serillius/TrashFlash/README.md

View this project on [CADLAB.io](https://cadlab.io/project/28978). 

# TrashFlash
