serillius/TrashFlash/3D_Model/BatteryConnector.png

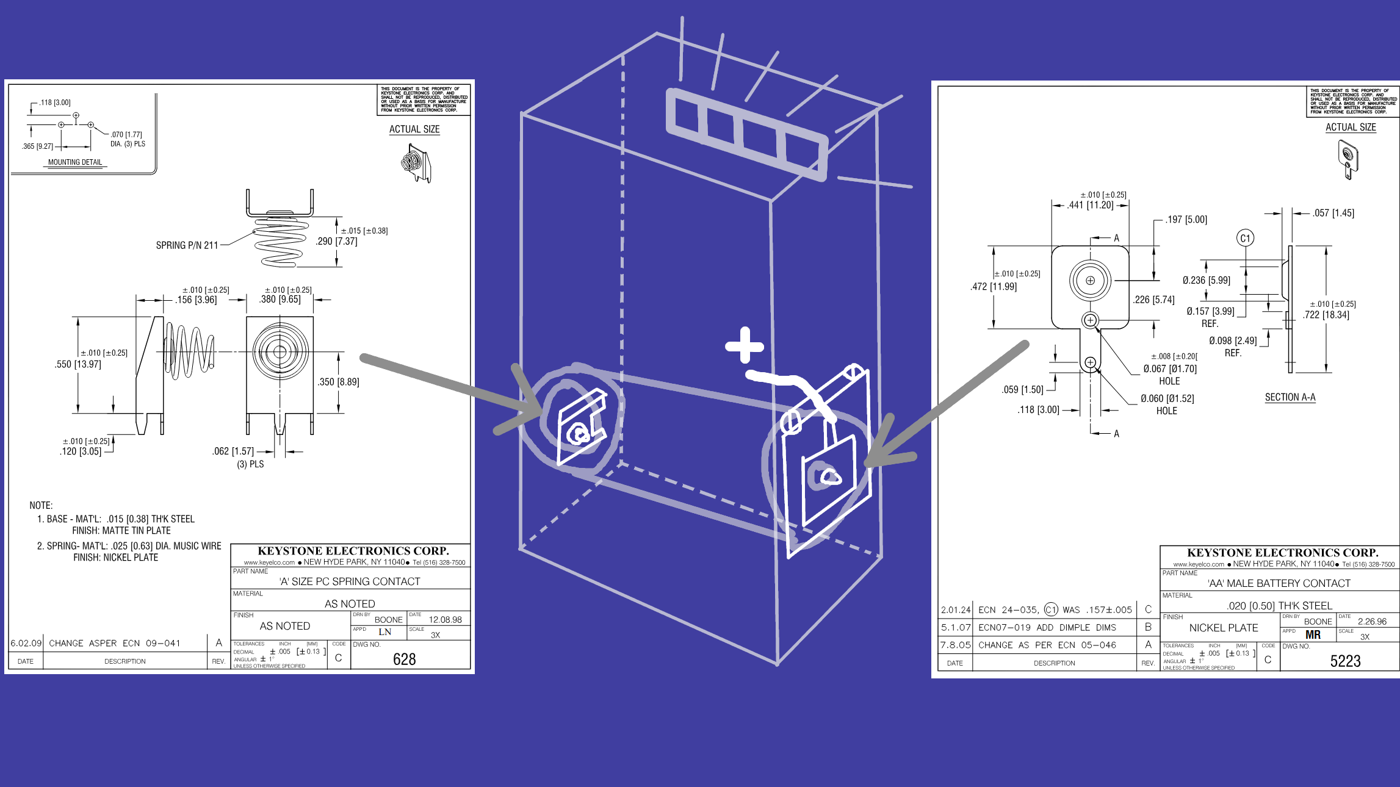
3D_Model/BatteryConnector.png
