serillius/TrashFlash/3D_Model/batteryAssembly.FCStd

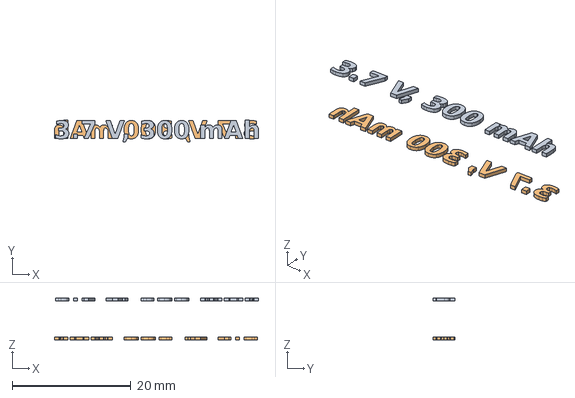
[picture p2: CAD file, 2025-04-07]
3D_Model/batteryAssembly.FCStd
34.4 x 3.71 x 7.00 mm
