serillius/TrashFlash/3D_Model/PCB_Assembly.FCStd

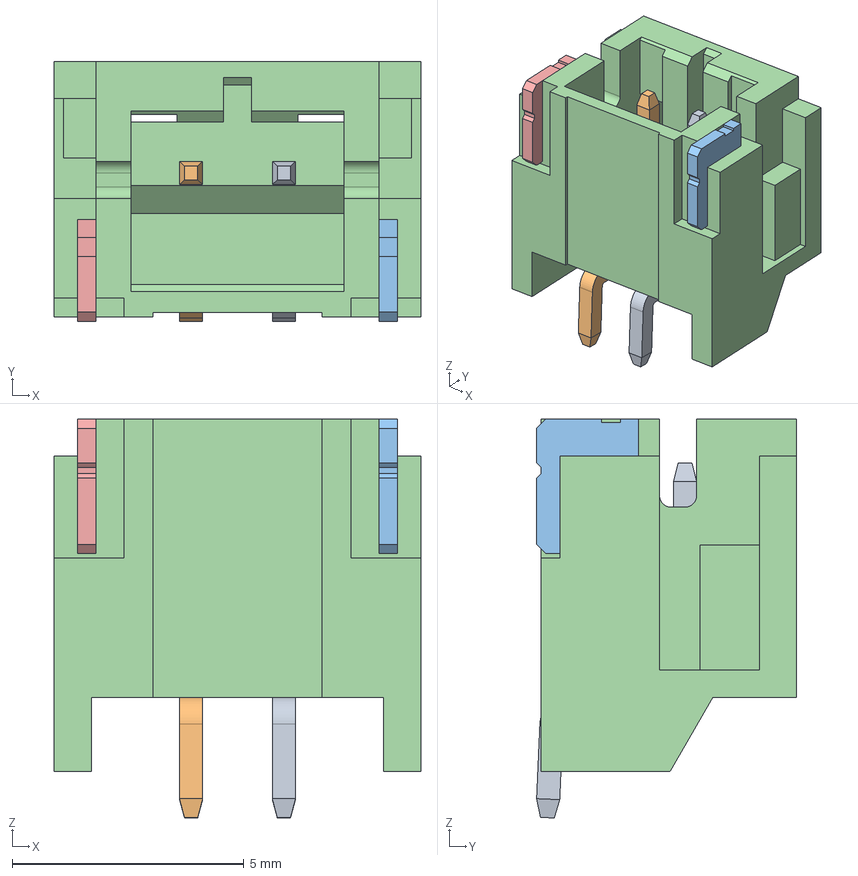
[picture p3: CAD file, 2025-03-31]
3D_Model/PCB_Assembly.FCStd
7.90 x 5.60 x 8.60 mm
S2B-PH-SM4-TB(LF)(SN)
S2B-PH-SM4-TB(LF)(SN)001
S2B-PH-SM4-TB(LF)(SN)002
S2B-PH-SM4-TB(LF)(SN)003
S2B-PH-SM4-TB(LF)(SN)004
