serillius/TrashFlash/3D_Model/CAP_UBY_18X25_NCH.step

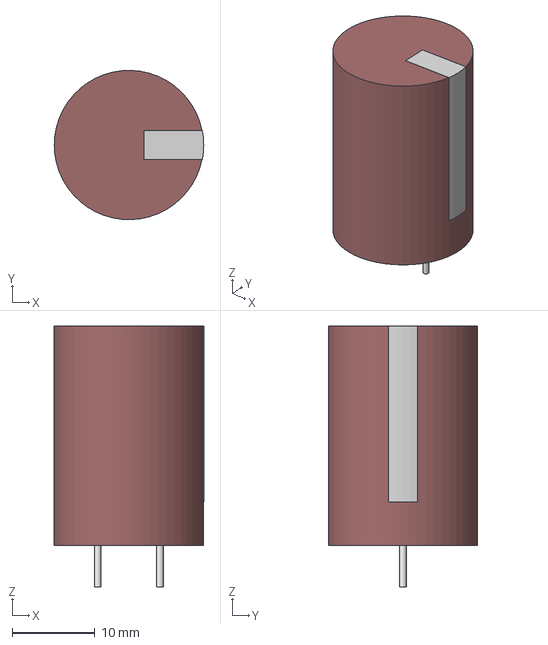
[picture p4: CAD file, 2025-04-09]
3D_Model/CAP_UBY_18X25_NCH.step
18.0 x 18.0 x 31.5 mm
