serillius/TrashFlash/Components/3D/FTSH-107-01-L-DV-K-A.stp

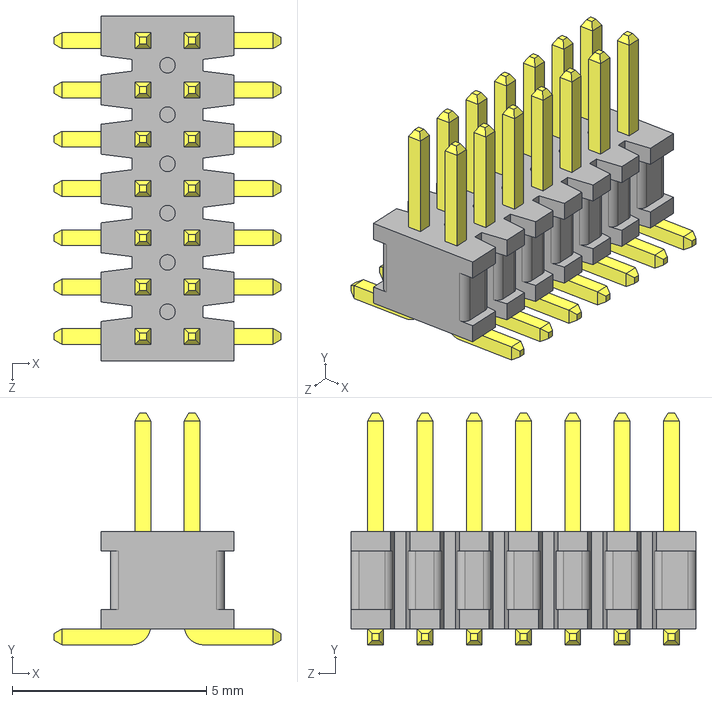
[picture p5: CAD file, 2025-04-23]
Components/3D/FTSH-107-01-L-DV-K-A.stp
5.84 x 5.97 x 8.89 mm
