serillius/TrashFlash/3D_Model/Battery.FCStd

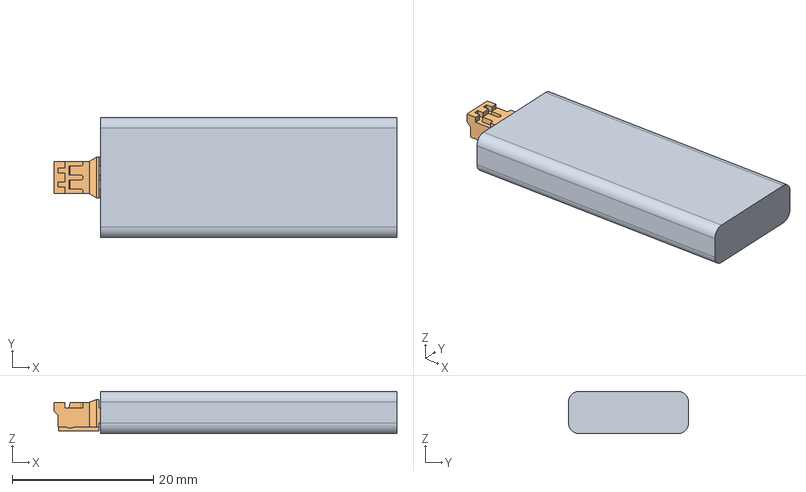
[picture p7: CAD file, 2025-04-07]
3D_Model/Battery.FCStd
48.6 x 17.0 x 6.00 mm
PHR-2
