serillius/TrashFlash/3D_Model/ec11e09244aq.stl

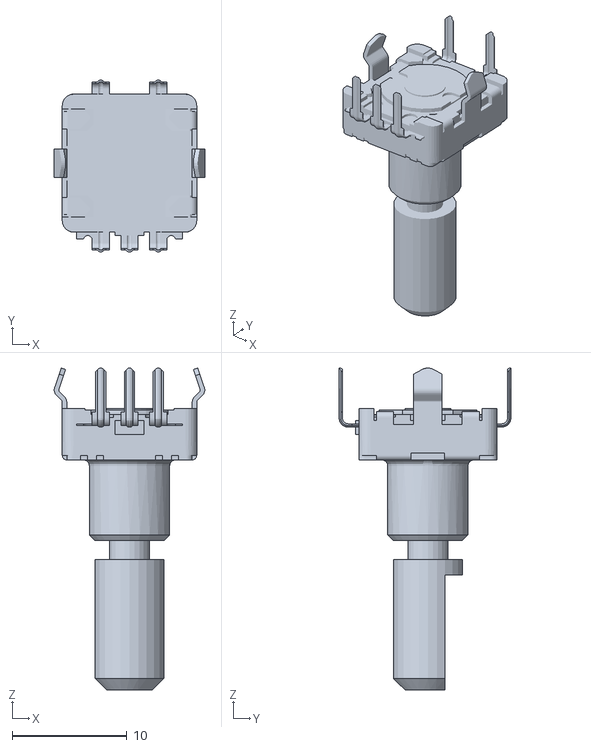
[picture p8: CAD file, 2025-04-06]
3D_Model/ec11e09244aq.stl
13.1 x 14.9 x 28.0
