serillius/TrashFlash/Components/3D/0900AT43A0070E.stp

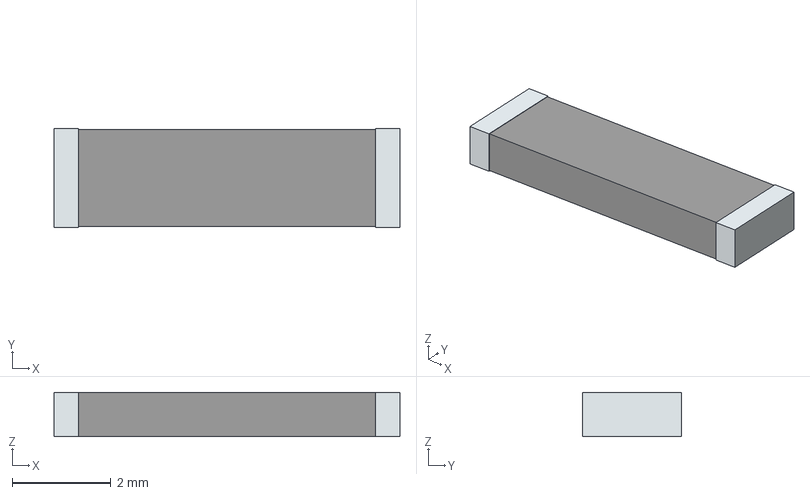
[picture p9: CAD file, 2025-04-23]
Components/3D/0900AT43A0070E.stp
7.00 x 2.00 x 0.9 mm
term1
term2
