serillius/TrashFlash/Components/3D/CC110LRGPR.stp

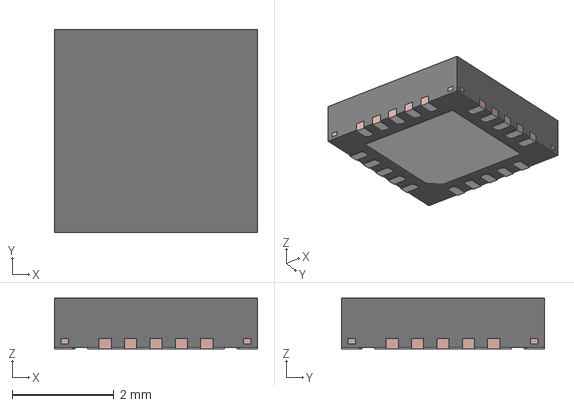
[picture p10: CAD file, 2025-04-23]
Components/3D/CC110LRGPR.stp
4.00 x 4.00 x 1.00 mm
FRAME
