serillius/TrashFlash/3D_Model/Hotshoe.FCStd

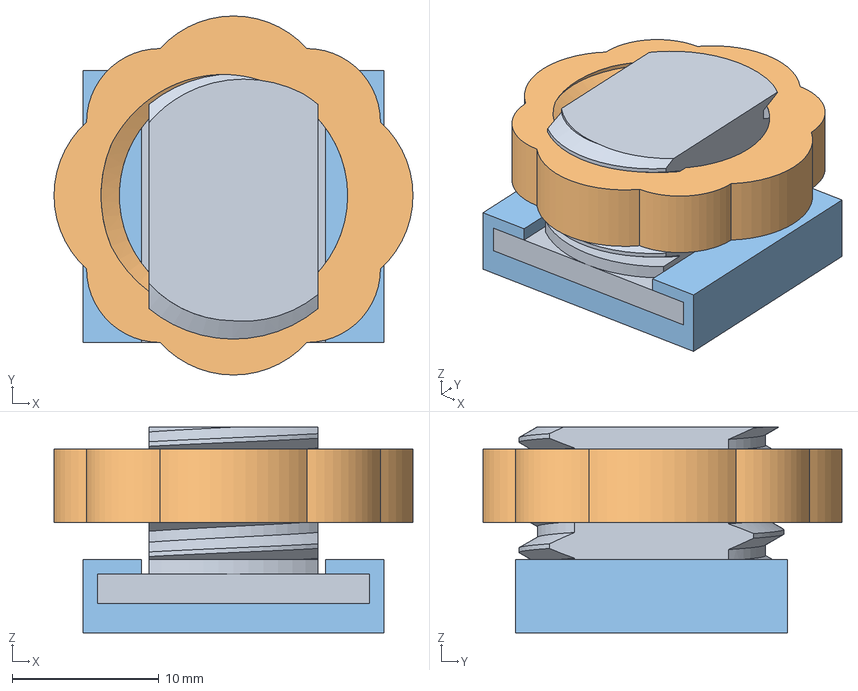
[picture p11: CAD file, 2025-03-31]
3D_Model/Hotshoe.FCStd
24.4 x 24.4 x 14.0 mm
Thread001
Hotshoe
