serillius/TrashFlash/3D_Model/XLamp XHP50.x HD.STEP

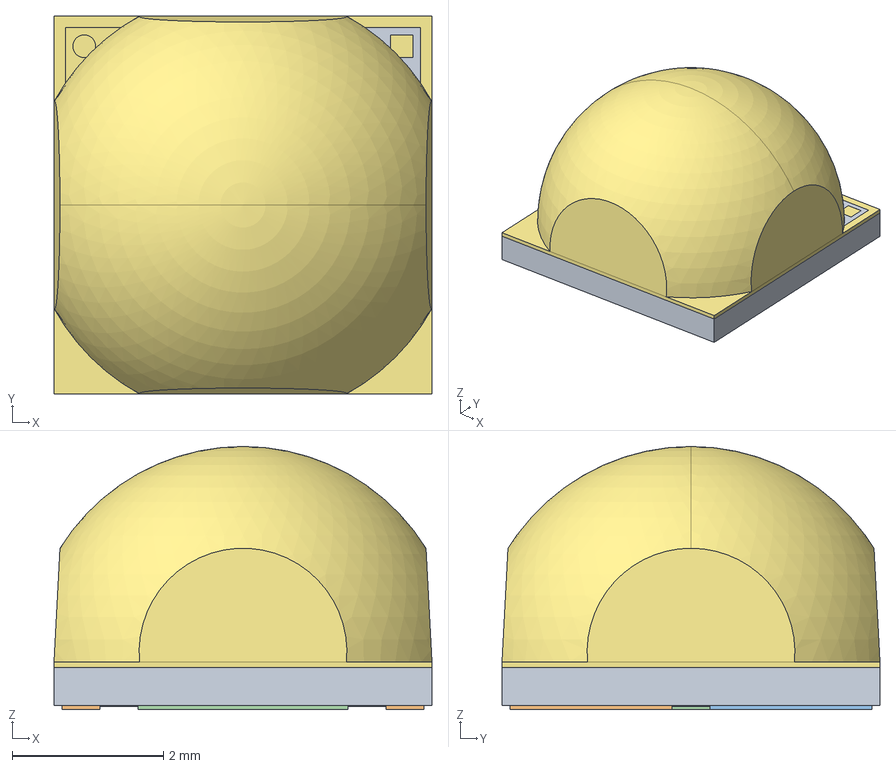
[picture p12: CAD file, 2025-03-31]
3D_Model/XLamp XHP50.x HD.STEP
5.00 x 5.00 x 3.48 mm
2500-00676-C
2500-00676-BT
2500-00676-SMB
2500-00676-SMB1
2500-00676-TT
2500-00676-TS
2610-00073-DOME
