serillius/TrashFlash/Components/3D/SN74LXC2T45QDTTRQ1.stp

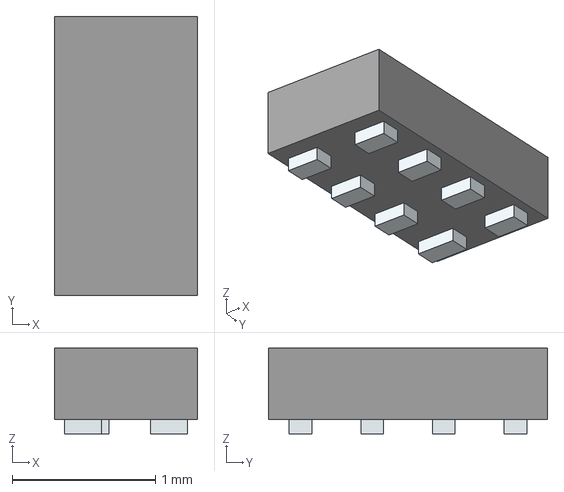
[picture p13: CAD file, 2025-04-07]
Components/3D/SN74LXC2T45QDTTRQ1.stp
1.00 x 1.95 x 0.6 mm
Pins
