serillius/TrashFlash/Components/3D/BC56-10PA,115.stp

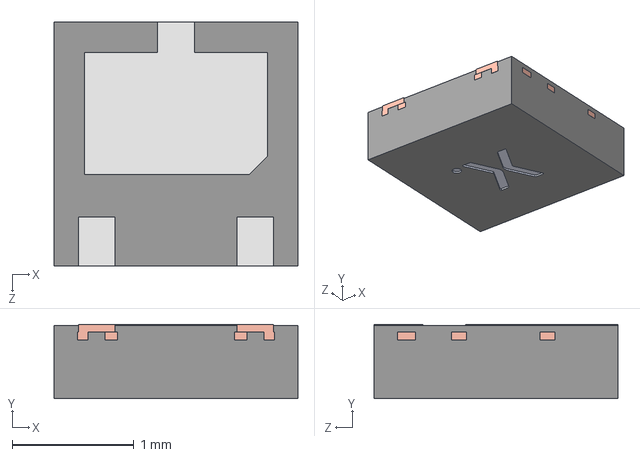
[picture p14: CAD file, 2025-04-07]
Components/3D/BC56-10PA,115.stp
2.00 x 0.61 x 2.00 mm
SOT1061A LF
SOT1061 Mold body
