serillius/TrashFlash/3D_Model/battery_Plug.step

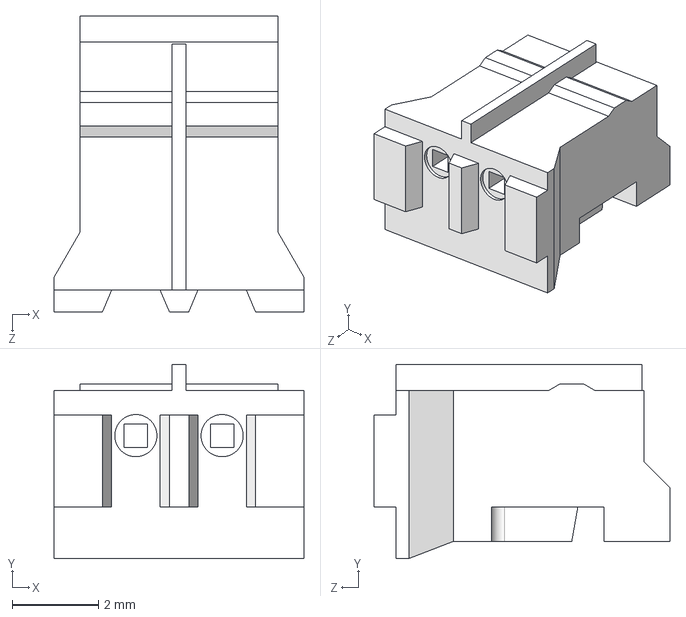
[picture p15: CAD file, 2025-03-31]
3D_Model/battery_Plug.step
5.80 x 4.50 x 6.85 mm
