serillius/TrashFlash/Components/3D/OPA191IDBVR.stp

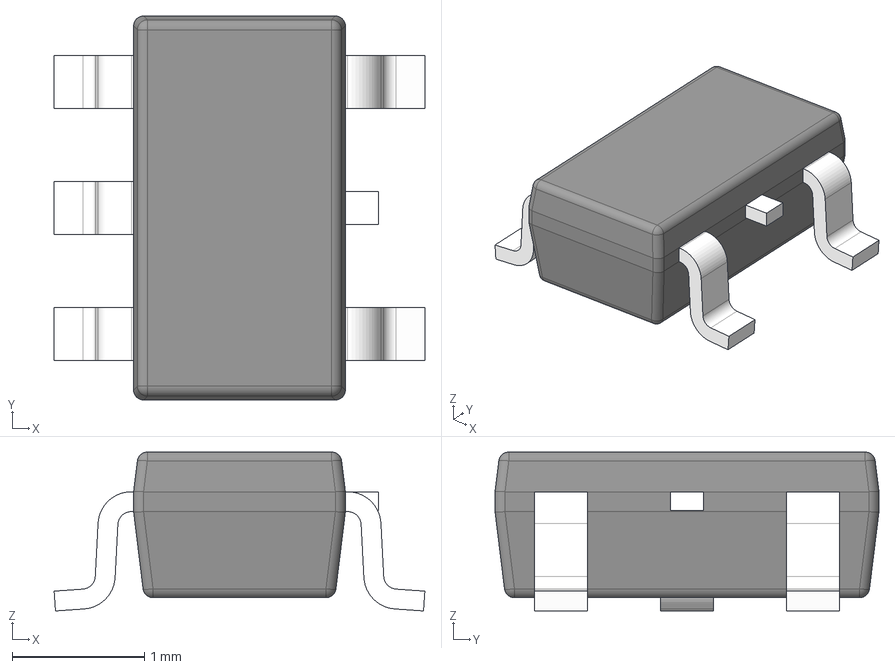
[picture p16: CAD file, 2025-04-07]
Components/3D/OPA191IDBVR.stp
2.80 x 2.90 x 1.20 mm
BODY-SOT
LEAD-SOT x 5
LEAD-DUMMY
