serillius/TrashFlash/Components/3D/SI5448DU-T1-GE3.stp

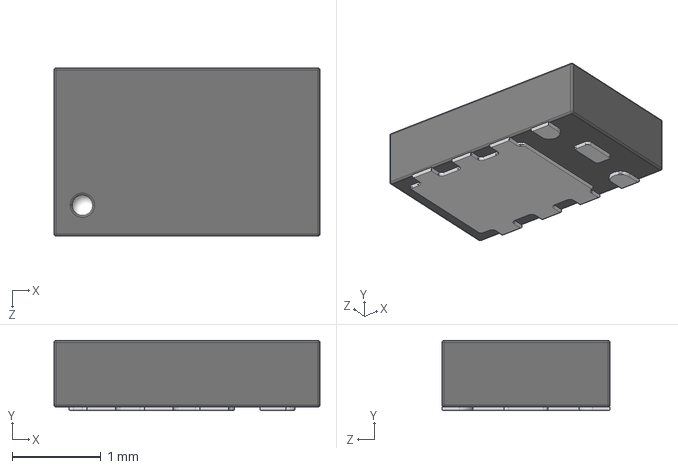
[picture p17: CAD file, 2025-04-07]
Components/3D/SI5448DU-T1-GE3.stp
3.00 x 0.79 x 1.90 mm
