serillius/TrashFlash/3D_Model/EEUFK1V332S.STEP

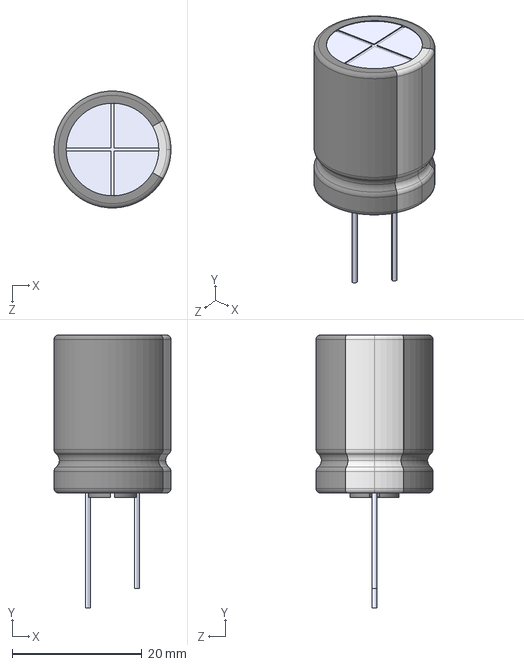
[picture p18: CAD file, 2025-03-31]
3D_Model/EEUFK1V332S.STEP
18.0 x 42.0 x 18.0 mm
