serillius/TrashFlash/Components/3D/PMDPB30XNAX.stp

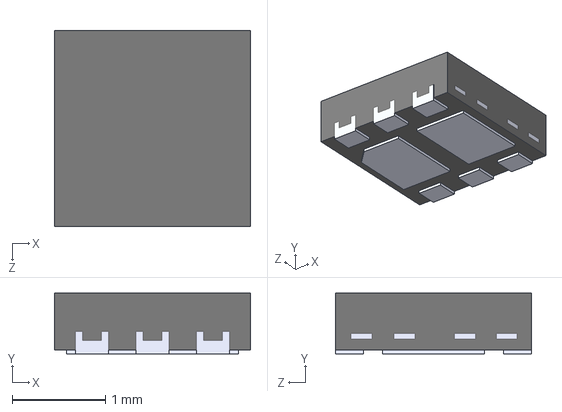
[picture p19: CAD file, 2025-04-07]
Components/3D/PMDPB30XNAX.stp
2.10 x 0.65 x 2.10 mm
