serillius/TrashFlash/Components/3D/AD8615AUJZ-REEL.stp

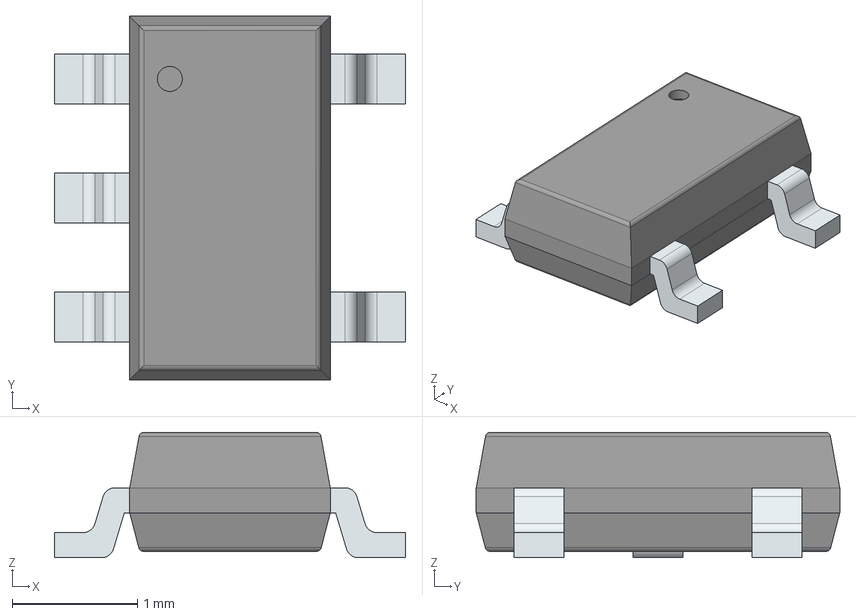
[picture p20: CAD file, 2025-04-07]
Components/3D/AD8615AUJZ-REEL.stp
2.80 x 2.90 x 1.00 mm
PinsArrayL
PinsArrayR
