serillius/TrashFlash/Components/3D/MCP4151-103E_MF.stp

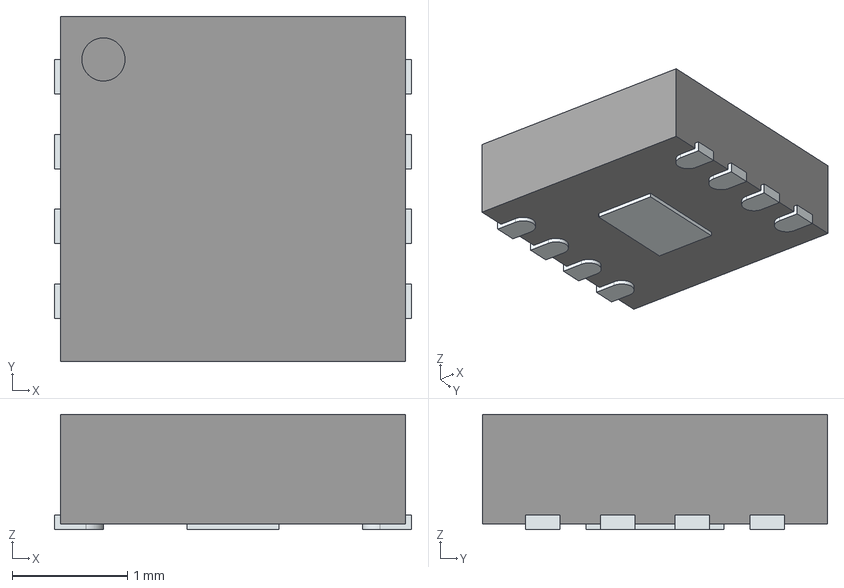
[picture p21: CAD file, 2025-04-07]
Components/3D/MCP4151-103E_MF.stp
3.10 x 3.00 x 1.00 mm
ThermalPin
PinsArrayLR
