serillius/TrashFlash/Components/3D/ADG5419BCPZ-RL7.stp

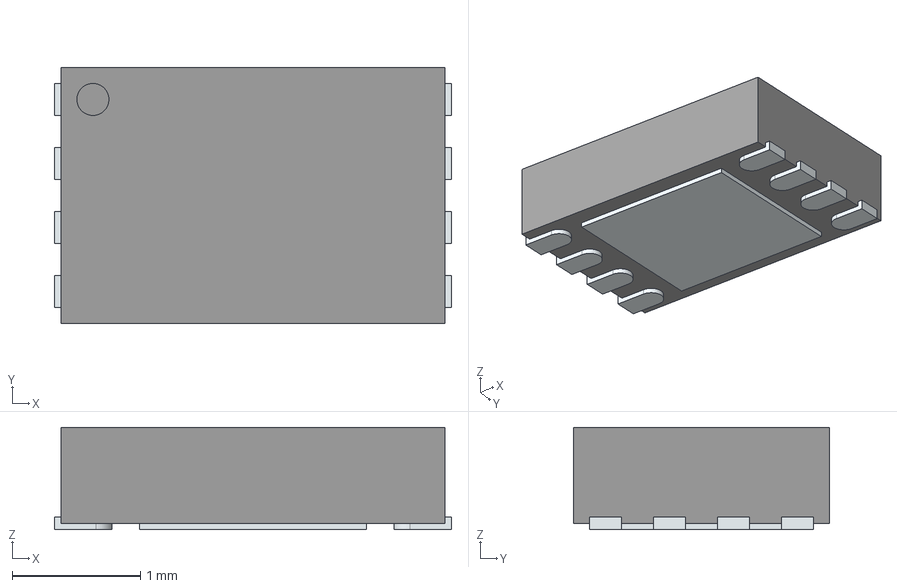
[picture p22: CAD file, 2025-04-07]
Components/3D/ADG5419BCPZ-RL7.stp
3.10 x 2.00 x 0.8 mm
ThermalPin
PinsArrayLR
