serillius/TrashFlash/Components/3D/LP5024RSMR.stp

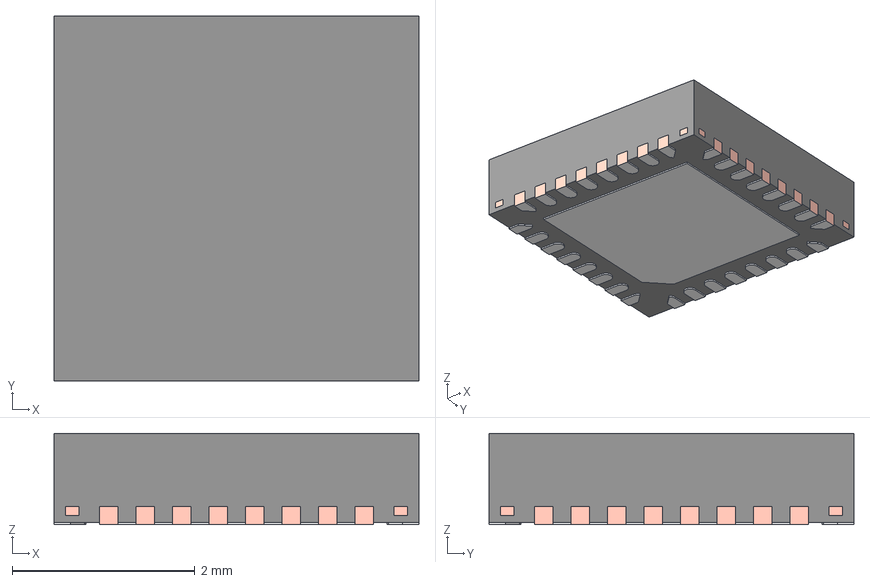
[picture p23: CAD file, 2025-04-07]
Components/3D/LP5024RSMR.stp
4.00 x 4.00 x 1.00 mm
BODY-QFN
FRAME-RSM0032B
PIN1-ID
