serillius/TrashFlash/Components/3D/LTC3643IUDD#PBF.stp

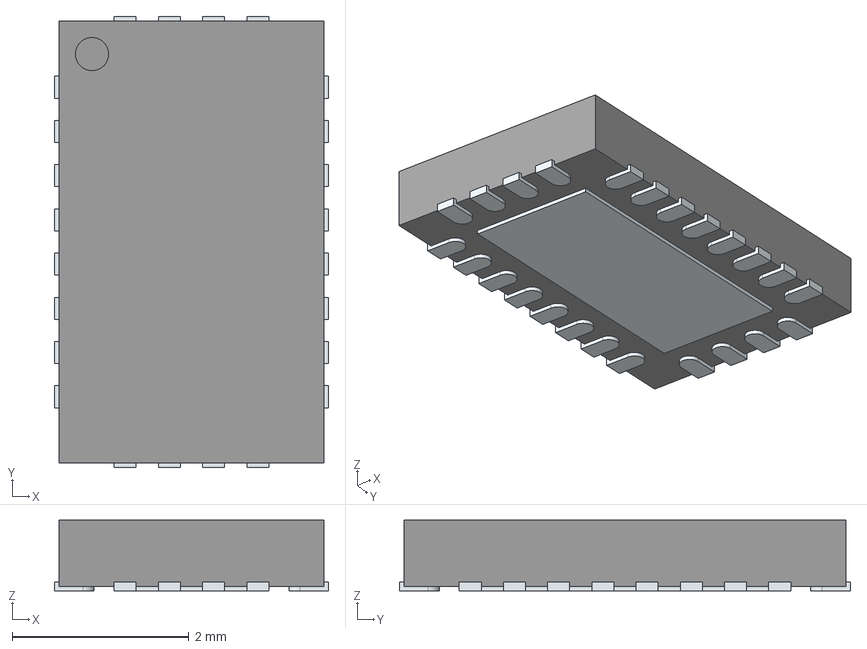
[picture p24: CAD file, 2025-04-07]
Components/3D/LTC3643IUDD#PBF.stp
3.10 x 5.10 x 0.8 mm
ThermalPin
PinsArrayLR
PinsArrayTB
