serillius/TrashFlash/Components/3D/628.stp

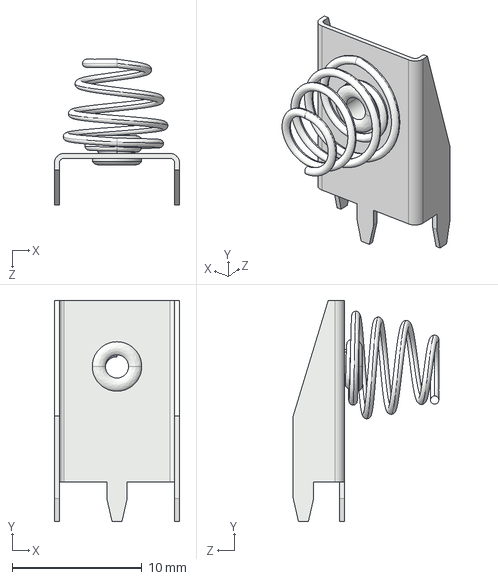
[picture p25: CAD file, 2025-04-06]
Components/3D/628.stp
9.65 x 17.0 x 11.2 mm
