serillius/TrashFlash/Components/3D/5223.stp

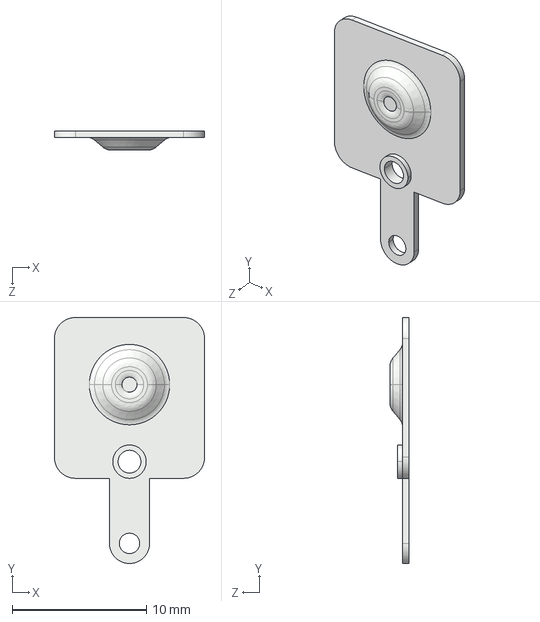
[picture p26: CAD file, 2025-04-06]
Components/3D/5223.stp
11.2 x 18.3 x 1.45 mm
