serillius/TrashFlash/(list of files, cad)

Other CAD files:
3D_Model/S2B-PH-SM4-TB.step
Components/3D/STM32U575QII6Q.stp
3D_Model/150080M153000.stp
3D_Model/CAP_UBY_18X25_NCH.stl
Components/3D/15130202601333.stp
Components/3D/1523020X601XXX_100893109MOD000B.stp
Components/3D/74438343022.stp
Components/3D/74438367068.stp
Components/3D/BQ24230RGTR.stp
Components/3D/BQ27426YZFR.stp
Components/3D/BQ29732DSER.stp
