serillius/TrashFlash/TrashFlash/TrashFlash.kicad_pcb

## KiCad design TrashFlash/TrashFlash.kicad_pcb (2025-05-06)

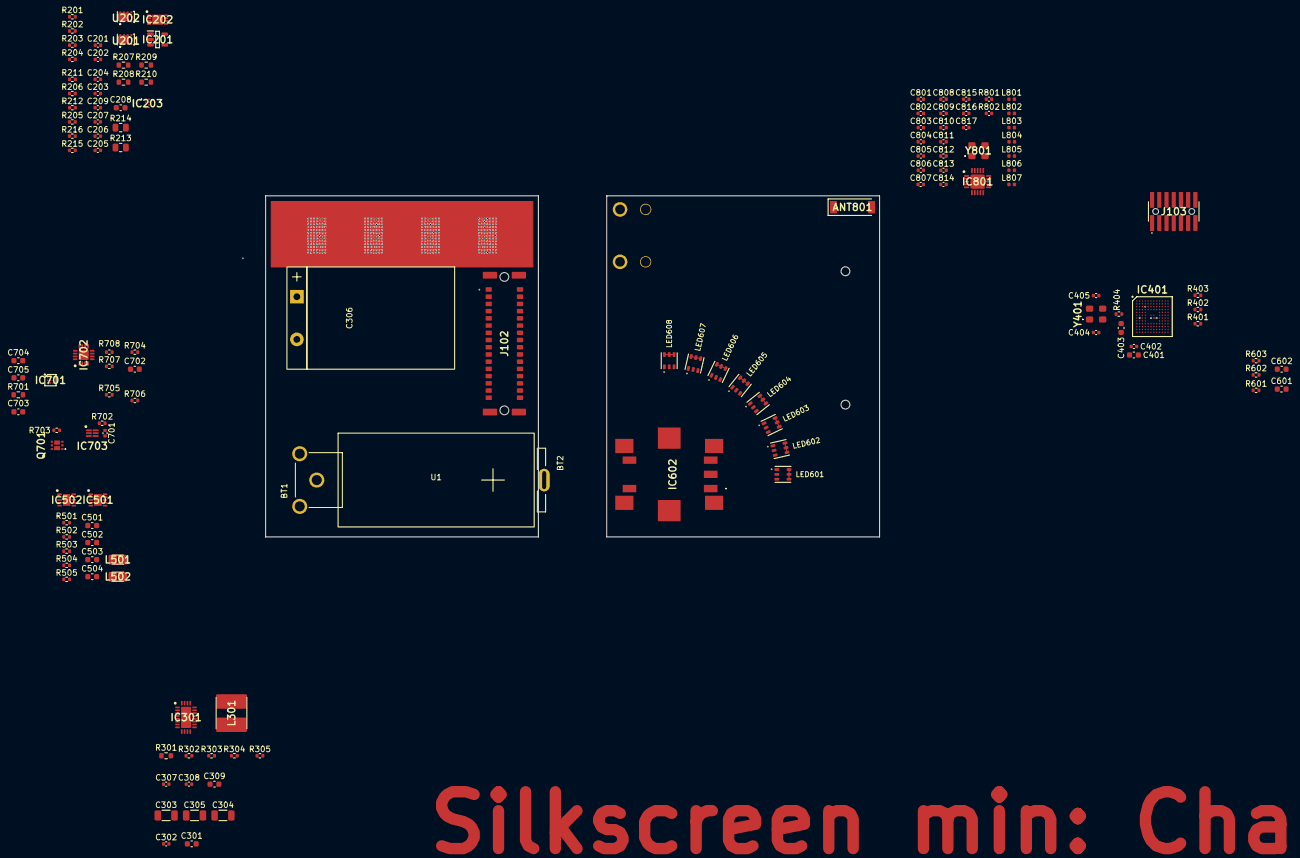
[picture p27: board TrashFlash.kicad_pcb from above]

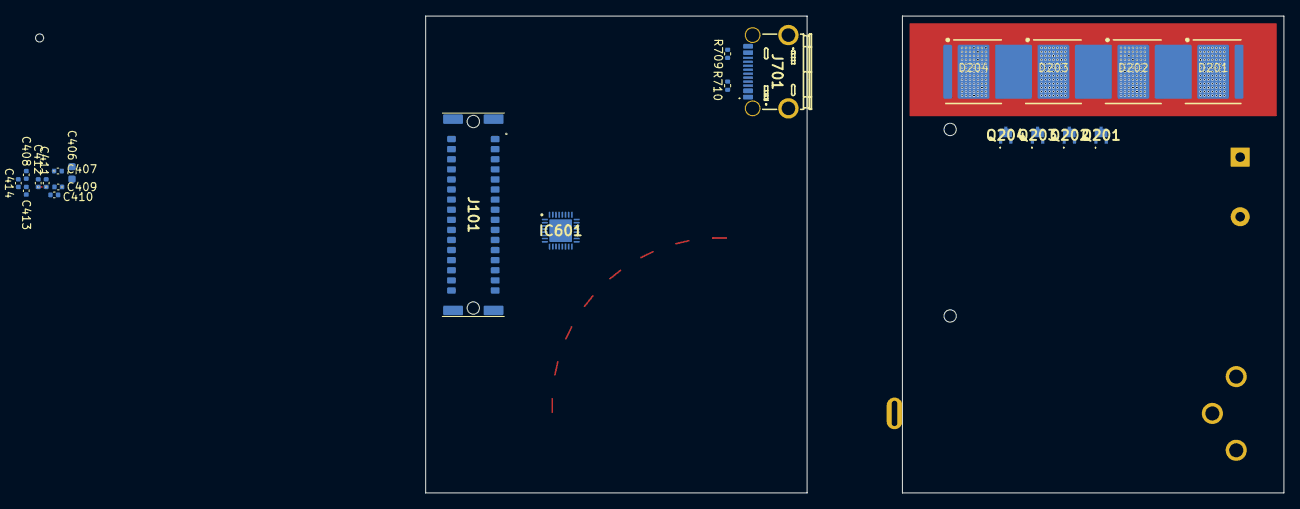
[picture p28: board TrashFlash.kicad_pcb from below]

Board: 6 copper layers, 108.0 x 60.0 mm, 157 parts (22 on the bottom side), 125 nets.

Parts:
ANT801: 0868AT43A0020001E; ANTC7020X90N
BT1: 628; BAT_628
BT2: 5223; BAT_5223
C201, C202, C803, C810: 100p; C_0402_1005Metric
C203, C204, C308: 22p; C_0402_1005Metric
C205, C206, C207, C209, C302, C407, C408, C409, C410, C411, C412, C413, C414, C701, C811, C817: 100n; C_0402_1005Metric
C208, C401, C403, C601, C602, C705: 1u; C_0603_1608Metric
C301, C309, C406, C703, C704: 4.7u; C_0603_1608Metric
C303, C304, C305: 10u; C_1206_3216Metric
C306: UBY1V392MHL6TN; CP_Radial_D16.0mm_P7.50mm
C307: 470p; C_0402_1005Metric
C402, C814, C816: 10n; C_0402_1005Metric
C404, C405: 6.8p; C_0402_1005Metric
C501, C503: 10u; C_0603_1608Metric
C502, C504: 22u; C_0603_1608Metric
C702: 2.2u; C_0603_1608Metric
C801, C804: 1.5p; C_0402_1005Metric
C802: 1p; C_0402_1005Metric
C805: 3.3p; C_0402_1005Metric
C806: 3.9p; C_0402_1005Metric
C807: 0.3p; C_0402_1005Metric
C808, C809: 10p; C_0402_1005Metric
C812, C813, C815: 220p; C_0402_1005Metric
D201, D202, D203, D204: XFL05K
IC201: AD8615AUJZ-REEL; SOT95P280X100-5N
IC202: ADG5419BCPZ-RL7; SON50P300X200X80-9N-D
IC203: SN74LXC2T45QDTTRQ1
IC301: LTC3643IUDD#PBF; QFN50P300X500X80-25N-D
IC401: STM32L471QEI6; BGA132C50P12X12_700X700X60
IC501, IC502: TPS63900DSKR; SON50P250X250X80-11N-D
IC601: LP5024RSMR; QFN40P400X400X100-33N-D
IC602: PEC11S-929K-S0015; PEC11S929KS0015
IC701: BQ27426YZFR; BGA9C50P3X3_158X162X62
IC702: BQ24230RGTR; QFN50P300X300X100-17N-D
IC703: BQ29732DSER; SON50P150X150X80-6N
IC801: CC110LRGPR; QFN50P400X400X100-21N-D
J101: 15130322601000
J102: 15230322601000
J103: FTSH-107-01-L-DV-K-A; FTSH-107-XX-YYY-DV-K-A
J701: USB4800-03-A; USB480003A
L301: 74438367068; INDPM5454X310N
L501, L502: 74438343022; INDM2016X100N
L801, L803, L804, L806: 12n; L_0402_1005Metric
L802, L805, L807: 18n; L_0402_1005Metric
LED601, LED602, LED603, LED604, LED605, LED606, LED607, LED608: 150282M153310
Q201, Q202, Q203, Q204: BC56-10PA,115; PTVS24VZ1UPAZ
Q701: PMDPB30XNAX
R201, R203, R205, R212: 100k; R_0402_1005Metric
R202, R204, R709, R710: 5.1k; R_0402_1005Metric
R206, R211: 10k; R_0402_1005Metric
R207, R208, R209, R210: 68m; R_0603_1608Metric
R213: 10m; R_0805_2012Metric
R214: 1; R_0805_2012Metric
R215, R216, R401, R402, R403, R404: 1k; R_0402_1005Metric
R301: 25m; R_0603_1608Metric
R302: 560k; R_0402_1005Metric
R303: 56k; R_0402_1005Metric
R304, R603: 12k; R_0402_1005Metric
R305: 400k; R_0402_1005Metric
R501: 511; R_0402_1005Metric
R502: 6.49k; R_0402_1005Metric
R503: 0; R_0402_1005Metric
R504: 8.25k; R_0402_1005Metric
R505: 36.5k; R_0402_1005Metric
R601, R602, R703, R704, R705: 2.2k; R_0402_1005Metric
R701: 10m; R_0603_1608Metric
R702: 330; R_0402_1005Metric
R706: 33K; R_0402_1005Metric
R707: 1.8K; R_0402_1005Metric
R708: 10K; R_0402_1005Metric
R801: 330; C_0402_1005Metric
R802: 56k; C_0402_1005Metric
U1: CR123A
U201, U202: SI5448DU-T1-GE3; SI5448DUT1GE3
Y401: ECS-160-8-33B2-CTN-TR3; ECS160833B2CTNTR3
Y801: ECS-260-10-33B-CKM-TR; ECS160833B2CTNTR3

Connections:
+5V: C206.1, C208.2, C209.2, C504.1, IC201.5 (V+), IC203.8 (VCCB), IC502.6 (VOUT), J101.A14, J101.B14, J102.A14, J102.B14, LED601.4 (A_BLUE), LED601.5 (A_GREEN), LED601.6 (A_RED), LED602.4 (A_BLUE), LED602.5 (A_GREEN), LED602.6 (A_RED), LED603.4 (A_BLUE), LED603.5 (A_GREEN), LED603.6 (A_RED), LED604.4 (A_BLUE), LED604.5 (A_GREEN), LED604.6 (A_RED), LED605.4 (A_BLUE), LED605.5 (A_GREEN), LED605.6 (A_RED), LED606.4 (A_BLUE), LED606.5 (A_GREEN), LED606.6 (A_RED), LED607.4 (A_BLUE), LED607.5 (A_GREEN), LED607.6 (A_RED), LED608.4 (A_BLUE), LED608.5 (A_GREEN), LED608.6 (A_RED)
+BATT: BT2.P1, IC701.C1 (SRP), IC701.C3 (BAT), R701.1, R702.1
-BATT: BT1.N1, BT1.N2, BT1.N3, C701.2, IC703.4 (VSS), Q701.1
/Battery_Management/BAT_CHARGER_INOUT: C703.1, IC701.C2 (SRN), IC702.2 (BAT_1), IC702.3 (BAT_2), R701.2
/Battery_Management/BIN: IC701.B1 (BIN), J102.A8
/Battery_Management/COUT: IC703.2 (COUT), Q701.5
/Battery_Management/DOUT: IC703.3 (DOUT), Q701.2
/Battery_Management/GPOUT: IC701.A1 (GPOUT), J102.B8
/Battery_Management/ISET_CHG: IC702.16 (ISET), R707.1
/Battery_Management/SCL: IC701.A3 (SCL), J102.A9, R705.2
/Battery_Management/SDA: IC701.A2 (SDA), J102.B9, R704.2
/Battery_Management/TMR_CHG: IC702.14 (TMR), R706.1
/Battery_Management/TS_CHG: IC702.1 (TS), R708.1
/Battery_Management/V-_PROT: IC703.6 (V-), R703.1
/Battery_Management/VCC_PROT: C701.1, IC703.5 (BAT), R702.2
/Battery_Management/~CHG: IC702.9 (~CHG), J102.A10
/Battery_Management/~PGOOD: IC702.7 (~PGOOD), J102.B10
/CC1: J701.A5 (CC1), R710.1
/CC2: J701.B5 (CC2), R709.1
/LED_Current_Source/EN_LED_RANGE_20A: IC203.2 (A1), J102.A4
/LED_Current_Source/EN_LED_RANGE_200mA: IC203.3 (A2), J102.B4
/LED_Current_Source/GATE_DRV_20A: IC203.7 (B1), R215.1
/LED_Current_Source/GATE_DRV_200mA: IC203.6 (B2), R216.1
/LED_Current_Source/LED_TP: D201.TP, D202.TP, D203.TP, D204.TP
/LED_Current_Source/SELECT_LED_RANGE: IC202.6 (IN), J102.A5
/LED_Current_Source/TCA_BASE_DRIVE: C204.1, IC201.1, Q201.1 (B), Q202.1 (B), Q203.1 (B), Q204.1 (B)
/LED_Current_Source/TCA_COLLECTOR: D204.1 (K), Q201.3 (C), Q202.3 (C), Q203.3 (C), Q204.3 (C), R203.2
/LED_Current_Source/TCA_CURRENT_FB: C203.1, IC202.1 (D), R206.1
/LED_Current_Source/TCA_EMITTER: R207.2, R208.2, R209.2, R210.2, R211.2, R213.1, R214.1
/LED_Current_Source/TCA_FB_20A: IC202.8 (SB), R213.2, U201.1
/LED_Current_Source/TCA_FB_200mA: IC202.2 (SA), R214.2, U202.1
/LED_Current_Source/TCA_NEG_IN: C204.2, IC201.4 (-), R211.1, R212.2
/LED_Current_Source/TCA_POS_IN: C203.2, IC201.3 (+), R205.2, R206.2
/LED_Current_Source/VMEAS_VDRIVE: C201.1, J102.A6, R201.1, R202.2
/LED_Current_Source/VMEAS_VLED: C202.1, J102.B6, R203.1, R204.2
/LED_Current_Source/VSET_LED_CURRENT: J102.B5, R205.1
/LED_Supply/BOOST_DRV: C302.2, IC301.15 (BOOST)
/LED_Supply/EN_LED_DRIVE_BOOST: IC301.7 (RUN), J102.A2
/LED_Supply/FBCAP: IC301.9 (FBCAP), R302.1, R303.1, R304.2
/LED_Supply/ILIM_DRV: C309.1, IC301.14 (INTVCC), IC301.21 (ILIM)
/LED_Supply/INDIS_DRV: IC301.16 (INDIS_1), IC301.17 (INDIS_2), L301.1
/LED_Supply/LED_DRIVE_CAPACITOR_CHARGED: IC301.11 (CAPGD), J102.B2
/LED_Supply/SW_DRV: C302.1, IC301.18 (SW_1), IC301.19 (SW_2), IC301.20 (SW_3), L301.2
/LED_Supply/VIN_DRV: C301.1, IC301.4 (VIN_1), IC301.5 (VIN_2), R301.2
/LED_Supply/VSET_LED_DRIVE_VOLTAGE: J102.A3, R303.2
/LED_Supply/~LED_DRIVE_INPUT_POWER_FAIL: IC301.12 (PFO), J102.B3
/MCU/BOOT0: IC401.H2 (NRST), R401.1, R403.2
/MCU/NRST: IC401.A4 (BOOT0), R402.1
/MCU/SCL_USER_INTERFACE: IC601.29 (SCL), R602.2
/MCU/SDA_USER_INTERFACE: IC601.28 (SDA), R601.2
/MCU/USB_DN: J701.A7 (DN1), J701.B7 (DN2)
/MCU/USB_DP: J701.A6 (DP1), J701.B6 (DP2)
/MCU/VREF: C403.1, IC401.L1 (VREF+)
/Supply/CFG1_5V: IC502.3 (CFG1), R505.1
/Supply/CFG1_VDD: IC501.3 (CFG1), R502.1
/Supply/CFG2_5V: IC502.4 (CFG2), R504.1
/Supply/CFG2_VDD: IC501.4 (CFG2), R501.1
/Supply/CFG3_5V: IC502.5 (CFG3), R503.1
/Supply/EN_5V_REG: IC502.1 (EN), J102.A7
/Supply/LX1_5V: IC502.9 (LX1), L502.1
/Supply/LX1_VDD: IC501.9 (LX1), L501.1
/Supply/LX2_5V: IC502.7 (LX2), L502.2
/Supply/LX2_VDD: IC501.7 (LX2), L501.2
/User_Interface/BLUE0: IC601.3 (OUT2), LED601.3 (K_BLUE)
/User_Interface/BLUE1: IC601.6 (OUT5), LED602.3 (K_BLUE)
/User_Interface/BLUE2: IC601.9 (OUT8), LED603.3 (K_BLUE)
/User_Interface/BLUE3: IC601.12 (OUT11), LED604.3 (K_BLUE)
/User_Interface/BLUE4: IC601.15 (OUT14), LED605.3 (K_BLUE)
/User_Interface/BLUE5: IC601.18 (OUT17), LED606.3 (K_BLUE)
/User_Interface/BLUE6: IC601.21 (OUT20), LED607.3 (K_BLUE)
/User_Interface/BLUE7: IC601.24 (OUT23), LED608.3 (K_BLUE)
/User_Interface/GREEN0: IC601.2 (OUT1), LED601.2 (K_GREEN)
/User_Interface/GREEN1: IC601.5 (OUT4), LED602.2 (K_GREEN)
/User_Interface/GREEN2: IC601.8 (OUT7), LED603.2 (K_GREEN)
/User_Interface/GREEN3: IC601.11 (OUT10), LED604.2 (K_GREEN)
/User_Interface/GREEN4: IC601.14 (OUT13), LED605.2 (K_GREEN)
/User_Interface/GREEN5: IC601.17 (OUT16), LED606.2 (K_GREEN)
/User_Interface/GREEN6: IC601.20 (OUT19), LED607.2 (K_GREEN)
/User_Interface/GREEN7: IC601.23 (OUT22), LED608.2 (K_GREEN)
/User_Interface/IREF_RGB: IC601.31 (IREF), R603.1
/User_Interface/RED0: IC601.1 (OUT0), LED601.1 (K_RED)
/User_Interface/RED1: IC601.4 (OUT3), LED602.1 (K_RED)
/User_Interface/RED2: IC601.7 (OUT6), LED603.1 (K_RED)
/User_Interface/RED3: IC601.10 (OUT9), LED604.1 (K_RED)
/User_Interface/RED4: IC601.13 (OUT12), LED605.1 (K_RED)
/User_Interface/RED5: IC601.16 (OUT15), LED606.1 (K_RED)
/User_Interface/RED6: IC601.19 (OUT18), LED607.1 (K_RED)
/User_Interface/RED7: IC601.22 (OUT21), LED608.1 (K_RED)
/User_Interface/VCAP_RGB: C602.1, IC601.32 (VCAP)
GND: C201.2, C202.2, C205.2, C206.2, C207.2, C208.1, C209.1, C301.2, C303.2, C304.2, C305.2, C306.2, C308.2, C309.2, C401.2, C402.2, C403.2, C404.2, C405.2, C406.2, C407.2, C408.2, C409.2, C410.2, C411.2, C412.2, C413.2, C414.2, C501.2, C502.2, C503.2, C504.2, C601.2, C602.2, C702.2, C703.2, C704.2, C705.2, C801.1, C805.2, C806.1, C807.1, C808.2, C809.2, C810.2, C811.2, C812.2, C813.2, C814.2, C815.2, C816.2, C817.2, IC201.2 (V-), IC202.3 (GND), IC202.7 (VSS), IC202.9 (EP), IC203.4 (GND), IC301.1 (PGND_1), IC301.2 (PGND_2), IC301.25 (SGND), IC401.D3 (VSS_1), IC401.E3 (VSS_2), IC401.F2 (VSS_3), IC401.F6 (VSS_4), IC401.F7 (VSS_5), IC401.F11 (VSS_6), IC401.F12 (VSS_7), IC401.J1 (VSSA/VREF-), IC501.5 (CFG3), IC501.8 (GND), IC501.11 (TP), IC502.8 (GND), IC502.11 (TP), IC601.25 (ADDR0), IC601.26 (ADDR1), IC601.33 (GND), IC602.C1 (C), IC602.E1 (E), IC701.B2 (VSS), IC702.4 (~CE), IC702.5 (EN2), IC702.8 (VSS), IC702.15 (TD), IC702.17 (TP), IC801.16 (GND_1), IC801.19 (GND_2), IC801.21 (GND_3), J101.A1, J101.A16, J101.B1, J101.B16, J102.A1, J102.A16, J102.B1, J102.B16, J103.5, J103.7, J103.11, J701.A1 (GND_1), J701.A12 (GND_2), J701.MH3, J701.MH4, J701.MH5, J701.MH6, Q701.4, R202.1, R204.1, R212.1, R304.1, R305.1, R403.1, R501.2, R502.2, R503.2, R504.2, R505.2, R603.2, R703.2, R706.2, R707.2, R708.2, R709.2, R710.2, R802.2, U201.2, U202.2, Y401.2 (GND), Y401.4 (GND), Y801.2 (GND), Y801.4 (GND)
unnamed: ANT801.1 (FEED), C807.2, L805.1
unnamed: C307.2, R305.2
unnamed: C801.2, C802.1, L801.1, L802.2
unnamed: C802.2, C804.1, L806.1, L807.1
unnamed: C803.1, L804.1
unnamed: C803.2, C806.2, L805.2
unnamed: C804.2, L802.1, L803.2
unnamed: C805.1, L803.1, L804.2
unnamed: C810.1, L807.2
unnamed: D201.1 (K), D202.2 (A)
unnamed: D202.1 (K), D203.2 (A)
unnamed: D203.1 (K), D204.2 (A)
unnamed: C307.1, C308.1, IC301.10 (ITH)
unnamed: C405.1, IC401.F1 (PH0-OSC_IN), Y401.3 (OUT/IN)
unnamed: IC401.G1 (PH1-_OSC_OUT), R404.1
unnamed: C702.1, IC701.B3 (VDD)
unnamed: C811.1, IC801.5 (DCOUPL)
unnamed: IC801.17 (RBIAS), R802.1
unnamed: IC801.13 (RF_N), L801.2
unnamed: IC801.12 (RF_P), L806.2
unnamed: C809.1, IC801.8 (XOSC_Q1), Y801.3 (OUT/IN)
unnamed: IC801.10 (XOSC_Q2), R801.2
unnamed: Q201.2 (E), R207.1
unnamed: Q202.2 (E), R208.1
unnamed: Q203.2 (E), R209.1
unnamed: Q204.2 (E), R210.1
unnamed: Q701.3, Q701.6
unnamed: R215.2, U201.3
unnamed: R216.2, U202.3
unnamed: C404.1, R404.2, Y401.1 (IN/OUT)
unnamed: C808.1, R801.1, Y801.1 (IN/OUT)
VBUS: C705.1, IC702.13 (IN), J101.A13, J101.B13, J102.A13, J102.B13, J701.A4 (VBUS_1), J701.A9 (VBUS_2)
VDD: C207.1, C401.1, C402.1, C406.1, C407.1, C408.1, C409.1, C410.1, C411.1, C412.1, C413.1, C414.1, C502.1, C601.1, C812.1, C813.1, C814.1, C815.1, C816.1, C817.1, IC202.5 (EN), IC203.1 (VCCA), IC203.5 (DIR), IC401.C4 (VDD_1), IC401.C11 (VDD_2), IC401.E2 (VBAT), IC401.G2 (VDD_3), IC401.G6 (VDD_4), IC401.G7 (VDDIO2), IC401.G11 (VDD_5), IC401.G12 (VDD_6), IC401.H3 (VDD_7), IC401.M1 (VDDA), IC501.6 (VOUT), IC601.27 (VCC), IC801.4 (DVDD), IC801.9 (AVDD_1), IC801.11 (AVDD_2), IC801.14 (AVDD_3), IC801.15 (AVDD_4), IC801.18 (DGUARD), J101.A15, J101.B15, J102.A15, J102.B15, J103.3, R401.2, R402.2, R601.1, R602.1, R704.1, R705.1
VSYS: C501.1, C503.1, C704.1, IC301.8 (FBSYS), IC301.13 (PFI), IC301.24 (CLP), IC501.1 (EN), IC501.2 (SEL), IC501.10 (VIN), IC502.2 (SEL), IC502.10 (VIN), IC702.6 (EN1), IC702.10 (OUT_1), IC702.11 (OUT_2), R301.1
Vdrive: C205.1, C303.1, C304.1, C305.1, C306.1, D201.2 (A), IC202.4 (VDD), IC301.3 (CAP), R201.2, R302.2
