serillius/TrashFlash/(commit log)

2025-03-24 started LED schematic
    [LED_Current_Source.kicad_sch, LED_Supply.kicad_sch, TrashFlash.kicad_sch]
2025-03-26 Added 3D model
    [Battery.FCStd, CAP_UBY_18X25_NCH.stl, EEUFK1V332S.STEP, Hotshoe.FCStd, PCB_Assembly.FCStd, S2B-PH-SM4-TB.step, XLamp XHP50.x HD.STEP, batteryAssembly.FCStd]
2025-03-30 Bevor new Shematic
    [MCU.kicad_sch, Supply.kicad_sch, TrashFlash.kicad_sch]
2025-03-31 Started redrawing shematic
    [LED_Current_Source.kicad_sch]
2025-03-31 LED_Current_Source.kicad_sch redesigne
    [LED_Current_Source.kicad_sch]
2025-04-01 Cleaned up LED_Current_Source schematic
    [LED_Current_Source.kicad_sch]
2025-04-05 Added Power Supply
    [LED_Supply.kicad_sch, Supply.kicad_sch]
2025-04-05 Added RGB leds/driver for user interface
    [TrashFlash.kicad_sch, User_Interface.kicad_sch]
2025-04-05 Added comment
    [LED_Current_Source.kicad_sch, User_Interface.kicad_sch]
2025-04-06 Changed SI51448 Footprint
2025-04-06 Added Battery Management
    [Battery_Management.kicad_sch, LED_Current_Source.kicad_sch, LED_Supply.kicad_sch, Supply.kicad_sch, TrashFlash.kicad_sch, User_Interface.kicad_sch]
2025-04-06 Added USB and powernets
    [Battery_Management.kicad_sch, LED_Current_Source.kicad_sch, LED_Supply.kicad_sch, Supply.kicad_sch, TrashFlash.kicad_sch, User_Interface.kicad_sch]
2025-04-06 Rotary encoder added + 3D stuff
    [150080M153000.stp, 5223.stp, 628.stp, Battery.FCStd, Battery_Management.kicad_sch, CR123A v4.step, LED_Current_Source.kicad_sch, LED_Supply.kicad_sch]
2025-04-07 Footprints 3D model fixed
    [74438343022.stp, 74438367068.stp, AD8615AUJZ-REEL.stp, ADG5419BCPZ-RL7.stp, BC56-10PA,115.stp, BQ24230RGTR.stp, BQ27426YZFR.stp, BQ29732DSER.stp]
2025-04-09 3d models and footprints
    [CAP_UBY_18X25_NCH.step, TrashFlash.kicad_pcb]
2025-04-11 Added Crystal to library
    [ECS-160-8-33B2-CTN-TR3.stp, STM32L471QEI6.stp]
2025-04-11 Added STM32L471 symbol to lib
2025-04-11 Added STM32L471 footprint to lib
2025-04-11 Added STM32 to schematic
    [LED_Supply.kicad_sch, MCU.kicad_sch]
2025-04-12 Added power supply to STM32
    [MCU.kicad_sch]
2025-04-12 Changed the layout of MCU schematic
    [MCU.kicad_sch]
2025-04-12 Added netlabels / cleaned up schematic
    [Battery_Management.kicad_sch, LED_Current_Source.kicad_sch, LED_Supply.kicad_sch, Supply.kicad_sch, User_Interface.kicad_sch]
2025-04-13 Added 3D-models to footprints, PCB outline and component placement
    [Battery_Management.kicad_sch, LED_Current_Source.kicad_sch, LED_Supply.kicad_sch, MCU.kicad_sch, STM32L471QEI6.stp, Supply.kicad_sch, TrashFlash.kicad_pcb, User_Interface.kicad_sch]
2025-04-23 Added Wireless and inter PCB connector
    [0900AT43A0070E.stp, 15130202601333.stp, 1523020X601XXX_100893109MOD000B.stp, Battery_Management.kicad_sch, CC110LRGPR.stp, LED_Current_Source.kicad_sch, LED_Supply.kicad_sch, MCU.kicad_sch]
2025-04-23 Old changes
    [5223.stp, 628.stp, Battery_Management.kicad_sch, TrashFlash.kicad_pcb]
2025-04-23 Added battery and connectors to PCB
    [TrashFlash.kicad_pcb]
2025-04-23 Stackup changed, Led placement adjusted
    [TrashFlash.kicad_pcb, TrashFlash.kicad_sch, User_Interface.kicad_sch]
2025-04-23 Moved USB and added JTAG connector
    [Battery_Management.kicad_sch, FTSH-107-01-L-DV-K-A.stp, MCU.kicad_sch, TrashFlash.kicad_pcb, TrashFlash.kicad_sch, User_Interface.kicad_sch, Wireless_Interface.kicad_sch]
2025-04-24 Added Caps to Battery Charger
    [Battery_Management.kicad_sch, TrashFlash.kicad_pcb]
2025-04-29 LED via stitch und han gmerkt das ich usversehe d batterie im letschte kommit use gno han sorry :)
    [LED_Current_Source.kicad_sch, TrashFlash.kicad_pcb]
2025-05-06 Added battery and connectors, Schematic remark for BQ297xx
    [Battery_Management.kicad_sch, LED_Current_Source.kicad_sch, LED_Supply.kicad_sch, MCU.kicad_sch, Supply.kicad_sch, TrashFlash.kicad_pcb, TrashFlash.kicad_sch, User_Interface.kicad_sch]
2025-05-06 Some layout suggestions
    [TrashFlash.kicad_pcb]
